michaelk99/SKY130_CT-DSM/(commit log)

2023-07-24 system-level/matlab/ctdsm/: matlab functions to model a 4th order CT-DSM, FF and FB loop filters, DAC and quantizer
2023-07-24 system-level/matlab/CIFB4_2bit.m: verify prototype coeff, dyn. range scaling, MSA, test several modulator non-idealities
2023-07-24 system-level/matlab/CIFF4_2bit.m: verify prototype coeff, dyn. range scaling, MSA, test several modulator non-idealities
2023-07-25 circuit-level/xschem/dsm/ctmod4_2bit_fb.sch: mixed-signal/level simulation of a CIFB-4th order CTDSM w/ 2-bit quantizer
    circuit-level/xschem/macro-models/ota_fd_2pole.sch,sym: OTA macro model for mixed-signal/level simulations
    [ctmod4_2bit_fb.sch, ota_fd_2pole.sch]
2023-07-25 circuit-level/xschem/dsm/dsm_lf_fb_diff_gmc.sch: verify STF and NTF of circuit level mapping w/ prototype coefficients
    [dsm_lf_fb_diff_gmc.sch]
2023-07-25 circuit-level/matlab/analyze_ms_results.m: calculate PSD of mixed-signal/level simulation
2023-07-25 circuit-level/matlab/mapCoeff2Circ.m: map prototype coeff to circuit level implementation, perform dyn. range scaling
2023-07-25 circuit-level/python/vcd2mat.py: convert VCD format to continuous vector and export as .mat
2023-07-25 circuit-level/xschem/macro-models/ota_macro_fullydiff.sch: testbench for 'ota_fd_2pole.sch'
    [ota_macro_fullydiff.sch]
2023-07-25 circuit-level/xschem/macro-models/adc_dac_macro.sch: 2-bit ADC/DAC cascade w/ current DACs using XSPICE models
    [adc_dac_macro.sch]
2023-07-25 circuit-level/xschem/aux-amp/ota_gm_boost_1.sch: folded-cascode OTA, testbench for aux-amp
    [ota_gm_boost_1.sch]
2023-07-25 circuit-level/xschem/aux-amp/: folded-casc. OTA designs w/ bias blocks
    [amp_gm_boost.sch, amp_gm_boost_2.sch, amp_gm_boost_bias.sch, amp_gm_boost_bias_2.sch]
2023-07-25 circuit-level/xschem/frontend/frontend_1.sch: circuit-level design of frontend Gm-cell
    [frontend_1.sch]
2023-07-25 circuit-level/xschem/frontend/: split up frontend circuit blocks into individual schematics and symbols
    [frontend_bias.sch, frontend_cmfb.sch, frontend_cmfb_ideal.sch, frontend_main.sch]
2023-07-25 circuit-level/xschem/frontend/frontend_tb_dc.sch: frontend testbench for ideal load conditions
    [frontend_tb_dc.sch]
2023-07-25 circuit-level/xschem/frontend/frontend_tb_int.sch: frontend testbench for real load condition
    [frontend_tb_int.sch]
2023-07-25 circuit-level/doc/mixed_signal_sim.md: docs for mixed-signal/level simulation work flow
2023-07-25 circuit-level/xschem/: remove simulation output data
2023-07-25 circuit-level/doc/mixed_signal_sim.md: add missing quotes
2023-07-25 circuit-level/doc/mixed_signal_sim.md: update requirements, and add commands/hints sections
2023-07-26 circuit-level/matlab/analyzeMixedSigResults.m: unify naming convention per directory
2023-07-26 circuit-level/matlab/analyzeMixedSigResults.m: add missing file
2023-08-08 circuit-level/xschem/frontend/frontend_tb_dc.sch: plot input impedance
    [frontend_tb_dc.sch]
2023-08-08 circuit-level/xschem/frontend/frontend_tb_int.sch: plot input impedance, reduce resistive load, otherwise the output current has no path
    [frontend_tb_int.sch]
2023-08-08 circuit-level/xschem/frontend/frontend_tb_dc.sch: verify Zin with transient simulation
    [frontend_tb_dc.sch]
2023-09-04 circuit-level/matlab/analyzeMixedSigResults.m: adjust FS range
2023-09-27 circuit-level/matlab/mapCoeff2CircPaper.m: area estimations
2024-02-01 system-level/matlab/dsm_fir_ciff_b_mom.m: work in progress to implement Fc along w/ first order coeff., should give more simpler circuit.
2024-02-01 system-level/python/dsm_fir_mom.ipynb: print coefficients
2024-02-01 circuit-level/matlab/sweepDirectPathFIRTaps.m: sweep n-taps to determine influence on MSA and passive area
2024-03-16 system-level/matlab/CIFF4_1bit.m: simulate fs-scaled prototype mod 100 times w/ random initial states
2024-03-19 system-level/matlab/CIFF4_1bit.m: run prototype 1000 times and extract avg. state maxima
2024-12-18 system-level/matlab/utility/calcPSDParam.m: skip signal power if signal_bins = 0
2025-03-11 system-level/matlab/dsm_fir_direct_path.m: use pulse_fir.m, prepare different FIR filter shapes, add delay if ELD=1, add comments and debug outputs
